voidmerve/assistive-glasses/tasarim/onizleme/baston_ic.png

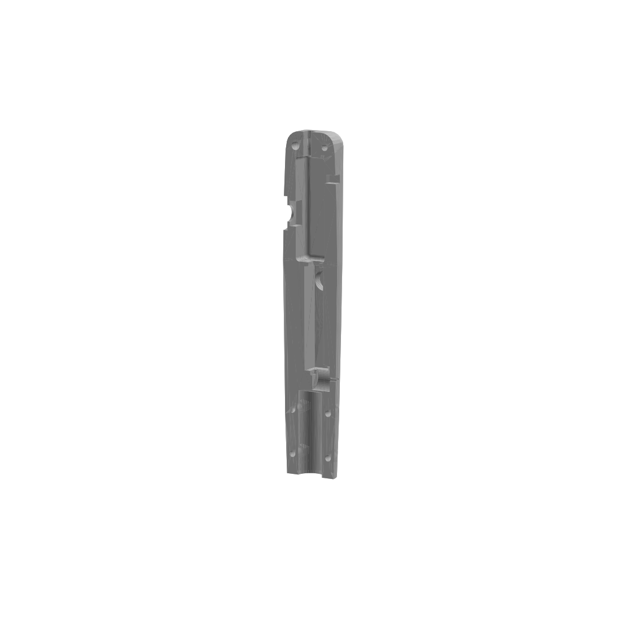
tasarim/onizleme/baston_ic.png
