voidmerve/assistive-glasses/tasarim/onizleme/gozluk_arka.png

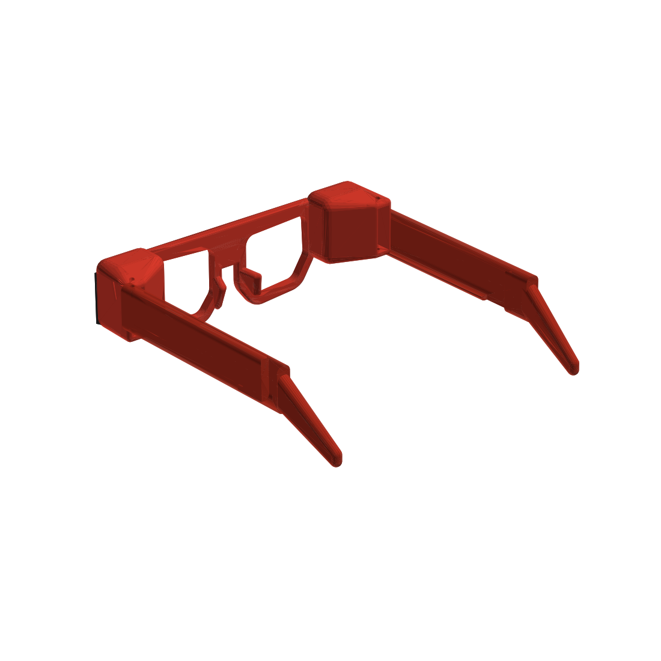
tasarim/onizleme/gozluk_arka.png
