voidmerve/assistive-glasses/tasarim/onizleme/gozluk_capraz.png

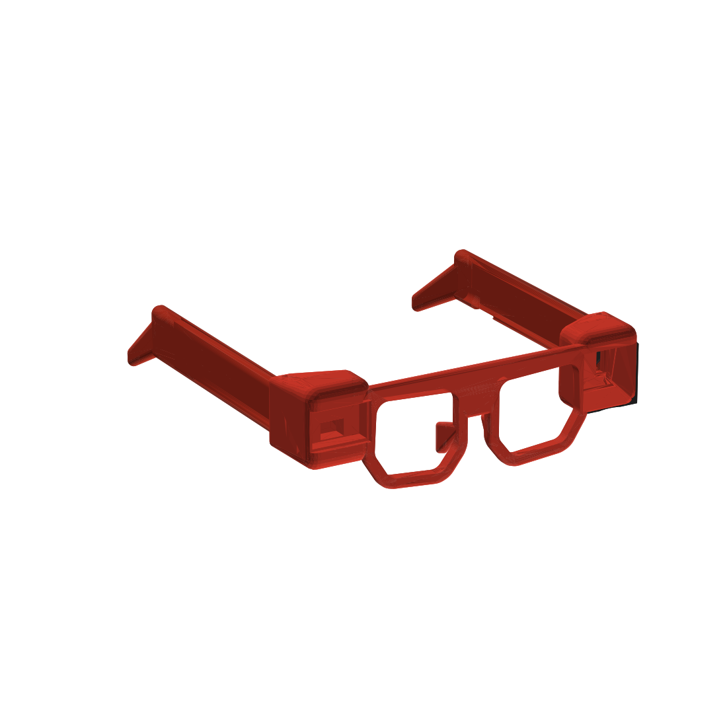
tasarim/onizleme/gozluk_capraz.png
