voidmerve/assistive-glasses/tasarim/onizleme/gozluk_on.png

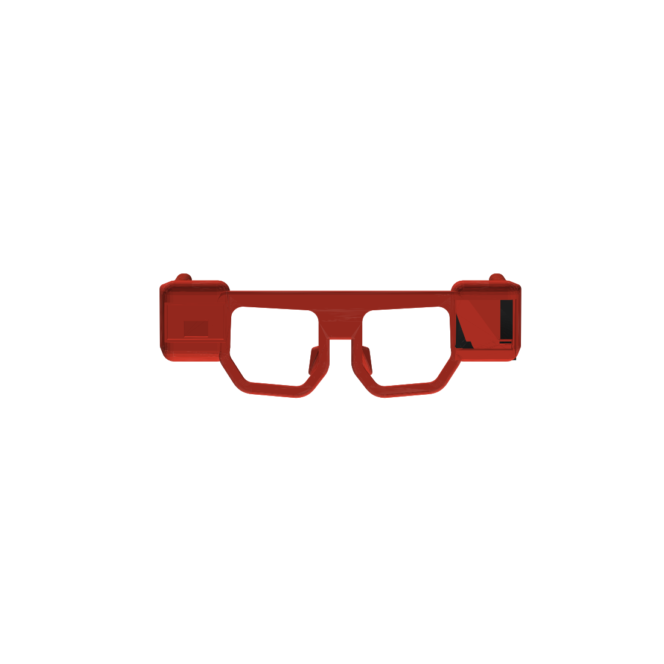
tasarim/onizleme/gozluk_on.png
