voidmerve/assistive-glasses/tasarim/onizleme/gozluk_ust.png

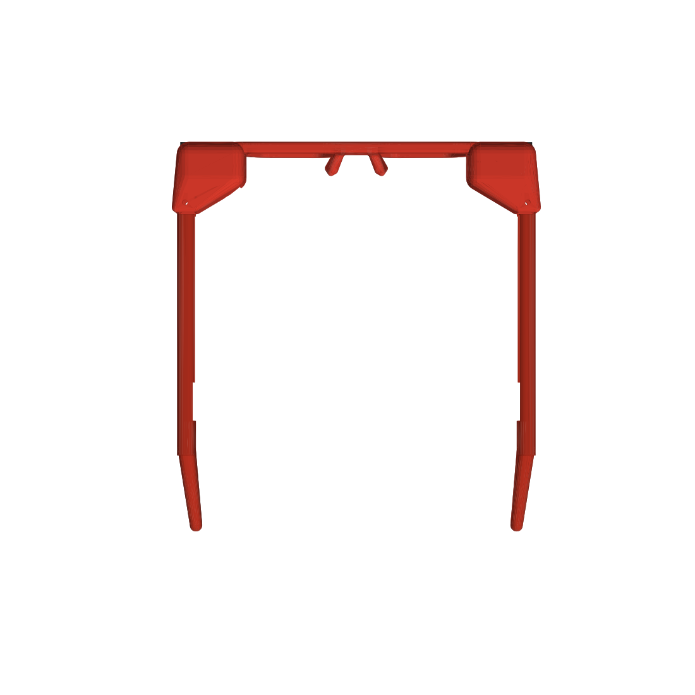
tasarim/onizleme/gozluk_ust.png
