voidmerve/assistive-glasses/tasarim/stl/gozluk_sap_sol.stl

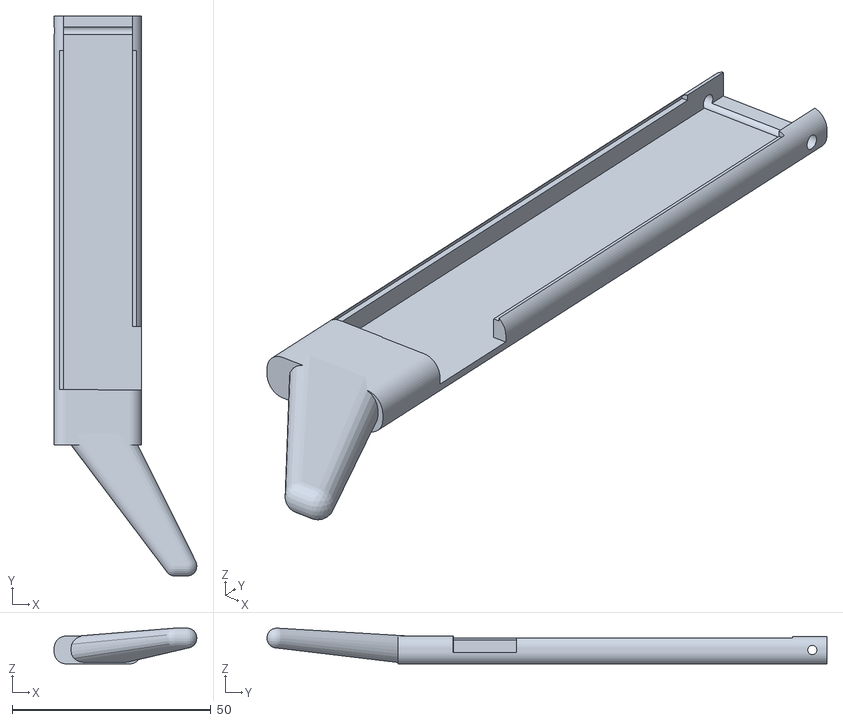
[picture p8: CAD file, 2026-10-09]
tasarim/stl/gozluk_sap_sol.stl
35.9 x 140.9 x 9.00
