voidmerve/assistive-glasses/tasarim/stl/gozluk_on_kapak_sensor.stl

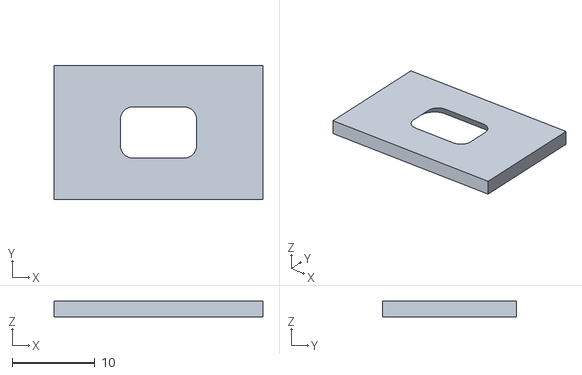
[picture p9: CAD file, 2026-10-09]
tasarim/stl/gozluk_on_kapak_sensor.stl
25.2 x 16.2 x 1.90
