voidmerve/assistive-glasses/tasarim/stl/gozluk_on_kapak_kamera.stl

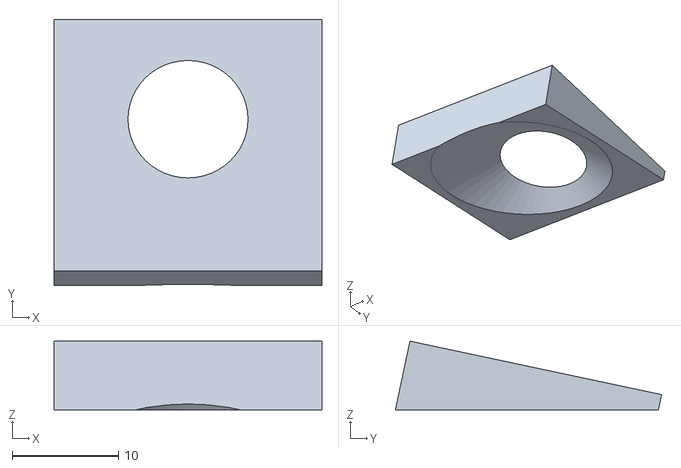
[picture p10: CAD file, 2026-10-09]
tasarim/stl/gozluk_on_kapak_kamera.stl
25.2 x 25.0 x 6.46
