voidmerve/assistive-glasses/tasarim/stl/baston_dugme_basligi.stl

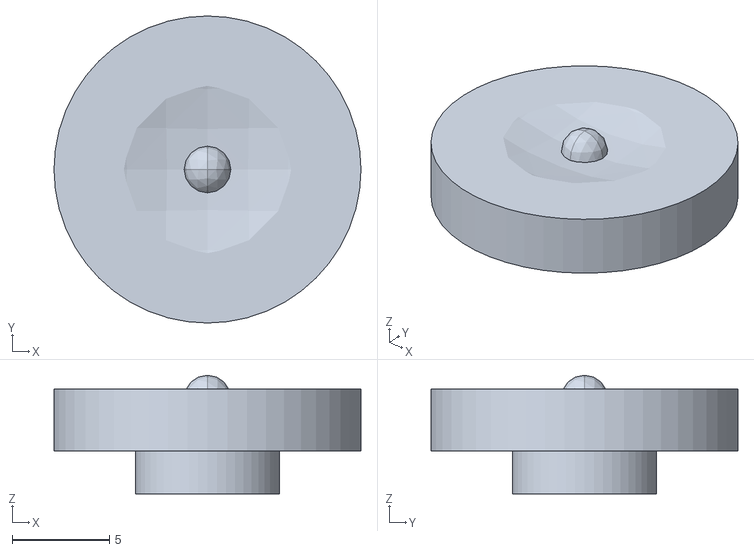
[picture p11: CAD file, 2026-10-09]
tasarim/stl/baston_dugme_basligi.stl
15.8 x 15.8 x 6.10
