voidmerve/assistive-glasses/tasarim/stl/test_kamera_yuvasi.stl

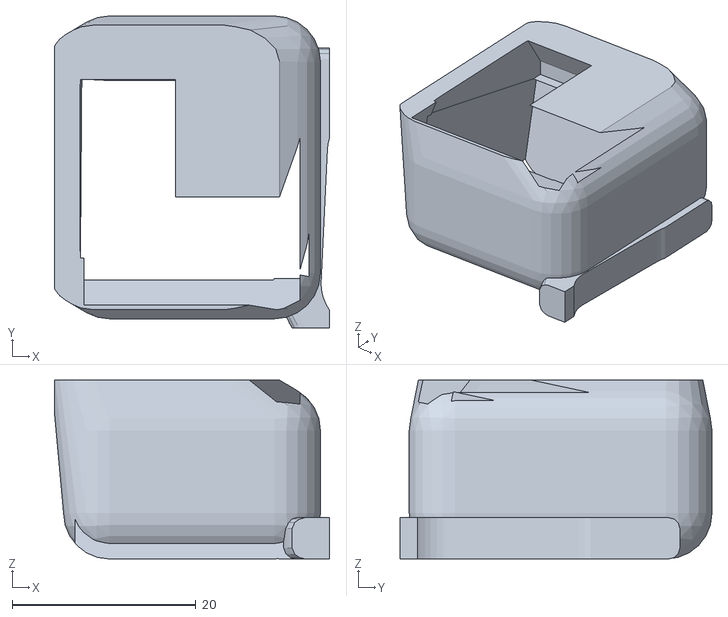
[picture p12: CAD file, 2026-10-09]
tasarim/stl/test_kamera_yuvasi.stl
30.0 x 34.0 x 19.5
