voidmerve/assistive-glasses/tasarim/stl/gozluk_kapak.stl

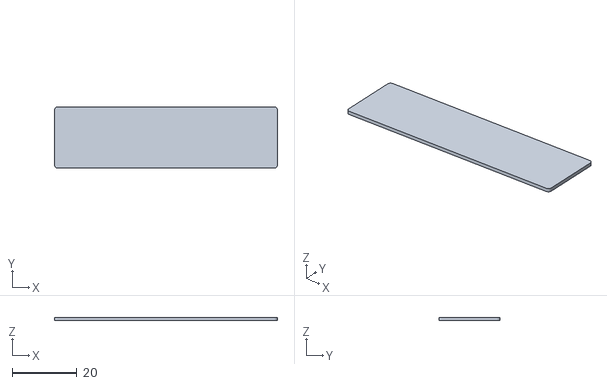
[picture p13: CAD file, 2026-10-09]
tasarim/stl/gozluk_kapak.stl
68.8 x 18.9 x 1.00
