voidmerve/assistive-glasses/tasarim/stl/baston_sap_sag.stl

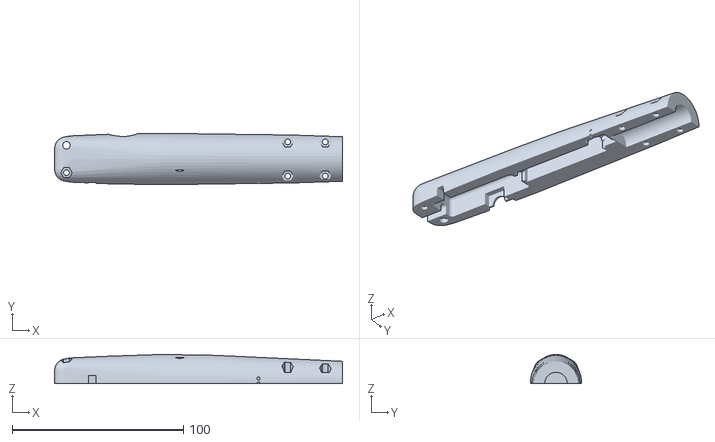
[picture p14: CAD file, 2026-10-09]
tasarim/stl/baston_sap_sag.stl
168.0 x 30.0 x 17.0
