voidmerve/assistive-glasses/tasarim/stl/gozluk_on.stl

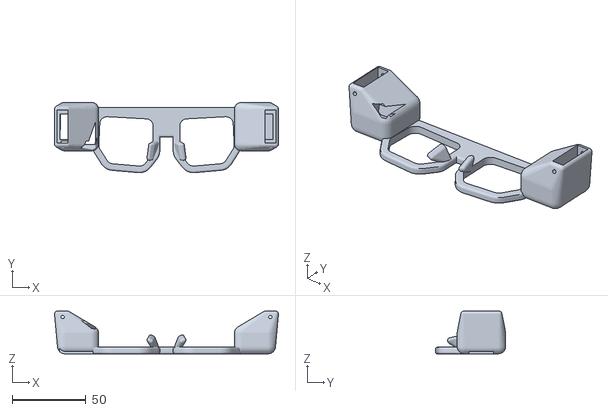
[picture p15: CAD file, 2026-10-09]
tasarim/stl/gozluk_on.stl
152.0 x 47.8 x 29.0
