voidmerve/assistive-glasses/(list of files, cad)

Other CAD files:
tasarim/stl/gozluk_sap_sag.stl
tasarim/stl/baston_sap_sol.stl
