voidmerve/assistive-glasses/(commit log)

2026-10-09 asama-1: kesilen sesi dogru raporla (paplay SIGTERM'de 0 ile cikiyor)
2026-10-09 asama-1b: carpismaya kalan sureye gore uyari, tik kanali, titresim, sozsuz durum tonlari
    - Mesafe esikleri yerine yaklasma hizi ve carpismaya kalan sure (TTC)
    - Dururken, kalabalikta ve bas cevirirken uyari yok
    - Tiklar konusmayi kesmeden ayni akisa karisiyor, yaklastikca hizlaniyor
    - 'Dur' sadece carpismaya 1 sn'den az kalinca
    - TITRESIM_PIN ile titresim motoru destegi
    - Internet kopma/gelme konusma yerine kisa ton
    - Simulasyona duvar_yaninda, kalabalik, bas_cevirme senaryolari
2026-10-09 asama-1c: tek dugmeli kontrol, modlar kalkti, saat yonu, konusma duzeyi
    - Kisa basis: onumde ne var (konusma suruyorsa susturur)
    - Uzun basis: soru, birakinca cevap. Cift basis: son soyleneni tekrarla
    - Ev/sokak modu ve surekli sokak tarifi kaldirildi, yapay zeka sadece sorulunca konusur
    - Sesli ayarlar internetsiz: kisa konus, detayli anlat, sessiz ol, durum ne, tekrar et
    - Yonler saat sistemiyle, sensor mesafesi Gemini'ye kesin bilgi olarak veriliyor
    - Internet ya da kota yokken kisa basis sensor olcumunu soyler
    - DUGME_PIN ile GPIO dugme, yoksa klavye (d / SPACE / r)
2026-10-09 asama-3: Gemini Live (gemini-3.8-live)
    - Cevaplar dogrudan ses olarak geliyor, ilk ses ~1-2 sn
    - Uzun basista mikrofon canli akiyor, birakinca cevap
    - Mesafe, ayar, durum ve navigasyon fonksiyon cagirma ile
    - Olay gozcusu: OLAY_ARALIGI_S'de bir kare, onemli bir sey yoksa model 'Yok' der ve calinmaz
    - Live sesi 'Dur' ve kisa basisla kesilebilir, cift basis son cevabi tekrarlar
    - Baglanti koparsa yeniden baglanir, bu arada REST + vosk + sensor yolu calisir
2026-10-09 tasarim: gozluk v2 ve akilli baston sapi (3D baski)
    - Gozluk: kamera ve sensor kose yuvalarinda, kablolar saplarin icindeki
    kapakli kanallardan gecip kulagin onunden cikiyor; kamera 12 derece asagi
    - Kart onden takiliyor, ayri basilan on kapak; saplar tek M2 ile
    - Baston: hazir katlanir bastona takilan iki yarim sap, boruyu vidalar sikar;
    XIAO ESP32C3, LiPo, 2 titresim motoru, dugme, MPU-6050, buzzer bolmeleri
    - Parametrik Python (manifold3d) kaynaklar, baski yonunde STL'ler, README
2026-10-13 kapsam: ev/sokak modu, esya hafizasi, sokak anlaticisi, navigasyon, juri paneli
    - Ev modu: sessiz yardimci; anahtar, cuzdan, telefon, bilgisayarin yerini metin
    olarak hatirlar (goruntu saklanmaz), 'anahtarim nerede' ile sorulur
    - Sokak modu: orta yol anlatici; olaylar hemen, yerler en fazla 30 sn'de bir,
    'daha cok/az anlat' ile degisir; gozcu turlari sessiz, fonksiyonla bildirir
    - 'Ne goruyorsun' zengin tarif, 'cevreyi tara' 5 kareyle saat yonlu tarama
    - Navigasyon: telefon GPS sayfasi (HTTPS), adim adim yonlendirme, rotadan
    sapinca yeniden hesaplama, 'neredeyim'; Maps anahtari yoksa OpenStreetMap
    - Juri paneli: kamera + YOLO kutulari, sensor grafigi, konusma dokumu,
    hafiza, harita,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
2026-10-14 kameradan mesafe: derinlik yapay zekasi sensorun yerine/yaninda
    - mesafe.py: Depth Anything V2 Metric Small dogrudan 252x196 girisle (~1 sn/kare,
    eski hat 5 sn), ev modunda ic, sokakta dis mekan modeli (DERINLIK_MODELI ile sabitlenebilir)
    - YOLO nesneleri icin saat yonu + mesafe; boyu bilinen nesnelerle kendi kendine kalibrasyon
    - SENSOR_MODU=kapali: sensor askida, simulasyon uyarilari yok, mesafe kameradan
    - Live, REST, internetsiz cevap ve mesafe_olc kamera mesafelerini kullaniyor
    - Sokak modunda kameradan kaba yaklasma uyarisi (KAMERA_UYARI)
    - Panel: derinlik haritasi, kutularda mesafe, nesne mesafe tablosu
    - Eski HF derinlik hatti kaldirildi (acilis daha hizli)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
2026-10-15 test geri bildirimi: cepte calisma, telefon kumandasi, kucuk esyalar, mesafe duzeltmesi
    - systemd kullanici servisi (servis/): SSH koparsa program kapanmaz, cikti gozluk.log
    - Telefon sayfasi kumanda oldu: onumde ne var, basili tut konus, tekrar, ev/sokak
    - Kamera 1280x960, Live'a 960x720 kare: anahtar/cuzdan gibi kucuk esyalar icin
    - Ev gozcusu: konum sabit esyaya gore ('koltugun uzerinde'), bakis yonu tarifleri reddedilir
    - YOLO hafizaya sadece yuzey/yakin esya bulduysa yazar
    - DERINLIK_CARPAN: genis acili lensin mesafeyi buyuk gostermesi icin duzeltme (0,75)
    - Panelde gozcu sayaclari
2026-10-15 test geri bildirimi 2: kameradan engel uyarisi, iki Live oturumu, telefon kumandasi duzeltmeleri
    - Engel uyarisi: yurume yolunun ortasinda 1,3 m'den yakin engel icin 'Onunde sandalye var,
    sagdan gec'; 0,7 m'den yakinsa bip + 'Dur'. Durunca da calisir, 8 sn'de bir hatirlatir.
    Cumleler Live sesiyle onceden kaydedildi (internetsiz, aninda)
    - Gorus hatti: YOLO + derinlik tek thread'de sirayla, 3 cekirdek; ic mekan modeli varsayilan;
    oturan insan kalibrasyonu bozmuyor
    - Iki Live oturumu: gozcu kareleri kullanici oturumunda birikip cevaplari 5-15 sn
    geciktiriyordu; simdi cevaplar 1-2 sn. Baglam siniri ve orta medya cozunurlugu
    - Akis oynaticisi acil ses beklerken Live dongusunu dondurmuyor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
2026-10-16 test geri bildirimi 3: yakin mesafe, karanlik, kulaklik bekcisi, sokak engel anlatimi
    - Mesafe: yakinda derinlik modeli insani/sandalyeyi uzak saniyordu (1 m'yi 4 m);
    YOLO kutusunun boy/genisliginden geometrik olcum eklendi, kutu karenin 1/3'unden
    buyukse sadece o kullanilir; engel uyarisi da bunu kullanir
    - Karanlik kare: model simsiyah kareye de ~1,1 m uyduruyordu; artik olcum ve uyari
    yok, 'kamera karanlik' denir
    - Kulaklik bekcisi (kulaklik.py): koparsa 8 sn'de bir yeniden baglanir, ses cikisi
    ve mikrofonu geri alir, panelde durum
    - Calinamayan uyari sesi log'a yazilir
    - Sokak gozcusu: 'engel' turu (park etmis bisiklet, direk, cop kutusu...), yerlerle
    ayni siklik siniri; gercek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
2026-10-16 sokak modu daha konuskan: 30 sn'de bir onundeki sey, dakikada bir cevre ozeti
    - Kullanici sormadan: SOKAK_TARIF_S (30) sn'de bir onundeki en onemli sey,
    SOKAK_CEVRE_S (60) sn'de bir genel cevre; konusurken/cevap ya da uyari calarken,
    basistan sonraki 10 sn, 'sessiz ol' ve karanlikta susar; 'daha cok/az anlat' carpar
    - Otomatik isteklere son bir dakikada soylenenler eklenir: ayni sey tekrarlanmaz
    - Engel uyarisi esigi 1,5 m; ayni olay 45 sn icinde tekrar edilmez
